erimozcan/CentrifugeFirmware/repo/esc_firmware/src/sensorless_observer.h

#ifndef SENSORLESS_OBSERVER_H
#define SENSORLESS_OBSERVER_H

#include <Arduino.h>

struct SensorlessObserverConfig {
  float polePairs;
  float phaseResistanceOhm;
  float phaseInductanceH;
  float kvRpmPerVolt;
  float pllKp;
  float pllKi;
  float minBemfVolts;
  float lockPhaseErrorRad;
  float lockRpmError;
  float lockDwellMs;
  float maxRpm;
  float latencySec;   // fixed frame-skew compensation applied as angle offset
                      // (= electricalOmega * latencySec; NEGATIVE retards). Bench-fitted
                      // 2026-07-17: the raw estimate LEADS the encoder reference frame by
                      // omega*240us (39deg@3800 / 44.8@4500 / 49.2@5000 RPM), so the
                      // production value is -240e-6 -- verified to null the bias to ~1 deg.
};

class SensorlessObserver {
 public:
  void begin(const SensorlessObserverConfig &cfg);
  void reset();   // zero all state WITHOUT claiming lock (resetFromElectrical latches
                  // locked=true for the handoff seed -- wrong for a fresh shadow start)
  void resetFromEncoder(float mechanicalAngleRad, float mechanicalRpm);
  void resetFromElectrical(float electricalAngleRad, float mechanicalRpm);
  void update(float ia, float ib, float ic,
              float uq, float ud, float voltageAngleElectrical,
              float encoderElectricalAngle, float encoderMechanicalRpm,
              float dt);

  float angleElectrical() const { return electricalAngle_; }
  float rpmMechanical() const { return mechanicalRpm_; }
  bool locked() const { return locked_; }
  float phaseErrorToEncoder() const { return phaseErrorToEncoder_; }
  float bemfVolts() const { return bemfVolts_; }

 private:
  static float wrapPi(float angle);
  static float normalizeAngle(float angle);

  SensorlessObserverConfig cfg_{};
  bool configured_ = false;
  bool locked_ = false;
  float electricalAngle_ = 0.0f;
  float electricalOmega_ = 0.0f;
  float mechanicalRpm_ = 0.0f;
  float lastIalpha_ = 0.0f;
  float lastIbeta_ = 0.0f;
  float lockMs_ = 0.0f;
  float phaseErrorToEncoder_ = 0.0f;
  float bemfVolts_ = 0.0f;
};

#endif
