erimozcan/CentrifugeFirmware/(commit log)

2026-07-12 Remove inherited dead code; stop tracking build artifacts
    - Delete the abandoned ODrive safety-kernel tree (src/, gen1_safety_kernel.ino)
    and its Due/ODrive-era docs (repo/PINOUT.md, repo/WIRING.md)
    - Delete the legacy Python CLI (repo/python/), superseded by the web operator UI
    - Delete the stale duplicate repo/firmware/src/main/main.ino
    - Untrack repo/firmware/.pio build artifacts (already gitignored)
    - Ignore local AI-assistant/analysis artifacts (.claude/, CLAUDE.md, graphify-out/)
    The 5th/ directory (abandoned STM32 MCSDK project, never tracked) was
    deleted from disk as well.
2026-07-12 Add the final device code: firmware, ESC firmware, operator UI, voice lines
    The complete software for the shipped centrifuge:
    - repo/firmware/: master-controller firmware for the Arduino Nano ESP32
    (state machine, safety interlocks, door/lock/fan/LED/audio drivers, ESC
    bridge, WiFi console server). Production env is nano_esp32; the bench
    diagnostic envs are kept and documented as service tools, and the Due
    product envs are removed (the Due was the prototype board).
    - repo/esc_firmware/: spindle ESC firmware (B-G431B-ESC1 + SimpleFOC).
    - repo/ui/: browser operator console (Web Serial over USB), including the
    self-contained single-file centrifuge-usb.html.
    - CentrifugeVoiceLines/: s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
2026-07-14 Raise RPM cap to 7000 (24 V bus validated); add live run-phase timers to UI
    - MAX_RPM_BAREBONES 4000 -> 7000 after the move to the 24 V bus and bench
    validation of the high-speed regime; docs updated accordingly
    - UI (both variants): raise speed input/clamp/bar full-scale to 7000
    - UI: live countdowns for ramp-up (LIFT/SEAT/MAIN), spin hold, and stopping,
    anchored on polled state transitions using the profile doRun() sent;
    shows elapsed time instead if the page loads mid-run
    - Regenerate embedded data/index.html.gz for the device-served WiFi console
2026-07-14 Add spindle service mode and high-speed controls
2026-07-14 Raise ESC current limits to 5A
2026-07-14 Fix ESC calibration safety gates
    [command_interface.cpp, main.cpp, test_esc_calibration_static.py]
2026-07-17 Harden high-speed sensorless mode and switch tube indexing to the ESC
    ESC (b_g431_esc1):
    - Supply-aware SPIN ceiling: min(10000, KV*(VBUS/2 - margin)) -- ~5720 RPM on
    12 V, full 10k only with -D SUPPLY_VOLTAGE=24.0f on the real 24 V bus.
    - Observer shadow validation now feeds the ACTUAL FOC voltages (motor.voltage
    q/d), not a hypothetical open-loop schedule.
    - Commanded ramp-down from sensorless speed hands back to encoder FOC at the
    crossover instead of riding the observer down into a cosmetic fault.
    - CAL: align waits CAL_LOCK_RELEASE_MS for the master to retract the gantry
    lock; encoder-still check handles TIM4 counter wrap.
    - New HOME verb captures the detent reference; INDEX tar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
2026-07-17 Never claim observer lock at standstill
    startCalibration() seeded the observer with resetFromElectrical(), which
    latches locked=true (the handoff seed) -- so ST telemetry showed obs_lock=1
    while the rotor sat still during CAL. Found during the powered-off dry test
    of the freshly flashed ESC. Add SensorlessObserver::reset() (zero state, no
    lock claim), use it at CAL start and on every disarm so no stale lock can
    survive into the next arm.
    Verified on hardware over the ST-LINK VCP: obs_lock=0 during CAL on both the
    default and _hs builds; full dry-test suite passes (verbs, profiles, HOME,
    watchdog, no-bus arm refusals, CAL lock-release dwell + graceful timeout).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
    [main.cpp, sensorless_observer.cpp, sensorless_observer.h, test_high_speed_supply_and_safety_static.py]
2026-07-17 Bench-harden indexing, calibration, and observer from powered testing
    First powered bring-up of the new ESC (daughterboard VCP, 12 V bench).
    Every change here is bench-driven:
    - INDEX reworked from an angle servo to a settled velocity crawl: a position
    loop closed through the assembly's stiction limit-cycles (observed: hunting,
    transient-crossing false arrivals). The crawl approaches fast, creeps near
    the target, cuts drive a stop-lead early, verifies a SETTLED arrival (dwell
    above the encoder's velocity-quantization noise floor), and takes bounded
    bidirectional correction passes with a pulsed stiction kick. Final bench
    result: 19/19, landings -5.0/+3.7/-0.4/-0.3/-0.3 deg, exact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
    [config.h, main.cpp, sensorless_observer.cpp, sensorless_observer.h, test_esc_calibration_static.py, test_esc_native_indexing_static.py, test_high_speed_supply_and_safety_static.py]
2026-07-17 High-speed regime: supervised encoder FOC full-range; handoff experimental
    Second powered bench session (new ESC, encoder remounted, bucketless rotor,
    12 V). Iterated the high-speed regime to a validated shipping architecture:
    - Observer frame-skew compensation SIGN was backwards and belongs ONLY in the
    supervision comparison: raw estimate LEADS the encoder frame by omega*240us
    (advance doubled the bias: 76/88/99 deg measured; retard nulls to ~1 deg),
    and compensating the PLL's own angle biased the sensorless drive frame
    (~45 deg torque-angle lag, 9 A). Compensation now applies only to
    phaseErrorToEncoder. Shadow lock validated on hardware: phase err within
    ~4 deg from 3800 to 5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
2026-07-17 Index crawl: sustain breakaway under bucket load
    Loaded regression (buckets reinstalled) exposed the last indexing gap: at the
    15 RPM creep the velocity-P term commands only ~2.4 A against the assembly's
    ~4.5 A stiction, so after every kick pulse the move re-stalled -- visible as
    back-and-forth jiggle at the bench, landings -13/-36 deg with retries
    exhausted. Creep raised to ~27 RPM (P-term ~4.2 A sustains motion once
    moving), kick pulse 40 -> 70 ms, retries 6 -> 8.
    Loaded results: indexing 19/19 (landings -0.4/-3.6/+2.9/-4.6/+5.0 deg,
    single-pass moves, bidirectional exact); full loaded regression on the
    default 4000-cap build: basic 13/13, CAL 6/6.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
    [main.cpp]
2026-07-17 Brisker door; INDEX re-send is a keep-alive, not a restart
    - Door drive raised per operator request: run duty 130 -> 160 (~63%), kick
    duty 100 -> 125. DOOR_SPEED verb still overrides live.
    - ESC: a re-sent INDEX for the same tube while the move/hold is live now
    acks and continues instead of restarting the crawl. The master re-sends
    INDEX every 250 ms until arrival (dropped-line robustness), and each
    restart raced the 200 ms settle dwell so arrival could never latch --
    found in the first full Nano end-to-end (post-R23/R24): standalone
    ROTATE limped through in 18.8 s, the post-run RUN_INDEX timed out and
    latched FAULT_ROTATE_TIMEOUT.
    - End-to-end otherwise proved the stack: Nano<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
2026-07-22 Fix missing home capture on the INDEX path; retune for low-friction gantry
    The rebuilt gantry (much less static friction) exposed two problems:
    - REAL ROOT CAUSE of "indexing off" and "homing off": maintainHome() was only
    called on the legacy velocity-rotate branch -- the ROTATE_VIA_INDEX dispatch
    never captured the detent reference or synced HOME to the ESC, so HOMED
    stayed 0 and every tube target was measured from wherever the ESC happened
    to power on. Pre-rebuild that was coincidentally near a detent. Fixed +
    regression test; verified on hardware (HOMED=1, ESC acks HOME).
    - Low-friction retune (staged; ESC flash pending ST-LINK): CRAWL velocity
    P 1.5 -> 0.5 (stiction-sized ga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
    [audio_controller.cpp, audio_controller.h, config.h, main.cpp, state_machine.cpp, test_esc_native_indexing_static.py]
2026-07-22 Smooth the index crawl: softer gains, gentler speeds, 2 A torque ceiling
    Landings were in tolerance but the move still jiggled on the low-friction
    gantry. Per operator request, power the motor less and soften everything:
    CRAWL velocity P 0.5 -> 0.3 (P x velocity quantization at creep dithers the
    torque), cruise 40 -> 30 RPM (smaller FAST->SLOW braking step), stall kicks
    rarer (200 -> 400 ms window) and softer (40 -> 30 ms pulse), and a dedicated
    2 A current ceiling for index moves (vs the global 5 A) so no correction can
    jerk the gantry -- restored with the spin profile on disarm.
    [main.cpp, test_esc_native_indexing_static.py]
2026-07-28 Door motor on the 24 V bus: PWM duty scaling instead of a 12 V buck
    The N20 door motor (BOM M2) is a 12 V-max part but the 24 V rework puts
    the DRV8871 VM straight on the 24 V rail (no enclosure room for the
    BOM's P2 buck). The 20 kHz slow-decay H-bridge PWM into the winding
    inductance is already a buck stage, so updateDoorMotor() now rescales
    every commanded duty (kick, run, UI DOOR_SPEED -- all calibrated on the
    12 V rail) by DOOR_MOTOR_RATED_V/DOOR_VM_VOLTAGE at the write. Average
    motor voltage is unchanged (255 commanded -> 127 applied); full VM can
    never reach the motor through the production path.
    The three bench tests that bypass this and kick at full VM
    (door_digi_test / door_test /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
    [config.h, door_digital_test.cpp, door_motor_test.cpp, door_move_test.cpp, hardware_guard.cpp]
2026-07-28 Enable the 24 V supply flag in the ESC high-speed env
    Flashed to the device 2026-07-28 as part of the 24 V single-bus
    migration (matching nano_esp32_hs on the master). The build must match
    the physical supply: do not spin on a 12 V bench supply with this
    configuration.
2026-07-28 UI: RCF units (r=52.5 mm); drop the high-speed toggle after 10k validation
    10,000 RPM on the 24 V bus was validated on the device 2026-07-28, so the
    opt-in "high-speed validation mode" checkbox + warning are gone -- the
    full range is simply the range. Operator speed is now RELATIVE
    CENTRIFUGAL FORCE (x g) at the 52.5 mm tube radius (RCF = 1.118e-5 x
    r[cm] x rpm^2); the machine protocol stays RPM underneath, with the raw
    RPM kept as the hero's secondary readout and in the debug telemetry.
    Max input is 5869 x g == the validated 10,000 RPM ceiling, DERIVED from
    MAX_RUN_RPM in code (floor keeps the converted rpm <= the firmware
    clamp). Deliberately NOT the requested 15,000 RPM equivalent (13,20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
2026-07-28 Raise the ceiling to 12000 RPM (8452 x g) -- the 24 V bus physical max
    After 10k validated on the device, open up the remaining supply headroom:
    KV*(VBUS/2 - margin) = 12320 ideal at 24 V, minus IR/load losses ~= 12k
    practical. MAX_SPIN_RPM_DESIGN and MAX_RPM_BAREBONES (hs) 10000 -> 12000;
    UI max 8452 x g (= 12k RPM at r 52.5 mm), still derived from MAX_RUN_RPM.
    MOTOR_VEL_LIMIT 200 -> 210 rev/s: it was exactly 12000 RPM and would have
    clipped the top-of-range velocity setpoint.
    Near the ceiling the measured speed falling short of the command is the
    bus limit, not a fault (documented in the source). 10k-12k needs the
    same incremental on-device validation as 7k-10k.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
    [config.h, main.cpp, test_high_speed_supply_and_safety_static.py, test_ui_high_speed.py]
2026-07-28 Raise the ESC spin current limit 5 -> 8 A (loaded-tube torque headroom)
    With tubes loaded, aero drag current-limited the spin at ~9.7k RPM
    (5.5k xg) with the phase current pegged at the 5 A clamp (bus draw read
    only ~2.5 A at 24 V -- same power, converter side). 8 A keeps 2.2x
    margin to the motor's 18 A / 200 W-for-30 s rating and 5x to the board's
    40 A peak (UM2516); expect ~6-7 A sustained at the loaded top, so watch
    motor temperature on long holds. The experimental (disabled) sensorless
    drive keeps its conservative 5 A trip. Requires PSU current limit >= 8 A.
2026-08-01 Lock at 95% throw; post-run bucket-tamp pass before the final lock
    The PQ12-R's position is linear in pulse width, so LOCKED becomes 1050 us
    (95% extend) -- the full throw over-drove the pin. The spun buckets are too
    light to fold back down, so after the post-spin index (door still closed)
    the gantry now visits the midpoint between each detent pair, where the
    bucket sits under the pin, and the lock presses to 75% (1250 us) to fold it
    flat, then retracts and moves on; after all four, the normal re-index,
    lock, and door-open run unchanged. New states RUN_TAMP_MOVE/RUN_TAMP_PRESS
    (19/20) keep the lock policy "released" through the pass so the rpm safety
    net and the lock audio cues behave; the p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
2026-08-01 Replace the bucket-tamp pass with a 50% sweeper knockdown turn
    Bench result: per-bucket 75% presses mostly worked, but a reworked lock tip
    with a sweeper extrusion does it better in one motion -- held at 50% extend
    it knocks each bucket flat as the gantry turns past it. After the post-spin
    index (door still closed) the lock now extends halfway, the gantry does one
    slow full revolution (30 RPM, crawl profile), then the normal re-index +
    lock + door-open follow. The turn's progress is measured on the ESC's
    cumulative rev= telemetry -- circular angle can't express "one full turn"
    (start == end) -- and stops 4% short so the re-index approaches the detent
    forward. States 19/20 become RUN_SWEEP_EX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
    [config.h, context.h, hardware_guard.cpp, hardware_guard.h, main.cpp, motor_interface.cpp, motor_interface.h, state_machine.cpp]
2026-08-01 Make the full-range _hs builds the default flash targets
    A plain `pio run -t upload` flashed the validation-era capped defaults
    (nano_esp32 = 4000 RPM master clamp; b_g431_esc1 = 12 V supply caps), which
    bit on 2026-08-01: a 4000 x g run silently clamped to 4000 RPM. The device
    has run the _hs configuration since the 24 V migration + 10k validation, so
    default_envs now points there in both projects and the env comments say
    which build the machine actually runs.
    Claude-Session: https://claude.ai/code/session_019sSbEiR3DxpyRa72cPWxa7
2026-08-03 Slew-limit the INDEX approach launch (bucket-slosh jerk guard)
    The index crawl stepped its velocity setpoint 0 -> FAST (~30 RPM) in one
    loop; through the boosted crawl PID that launch was hard enough to slosh
    loaded buckets on every from-rest move (initial index, tube rotate, the
    post-run and post-sweep re-indexes). Approach speed-ups now slew at
    INDEX_ACCEL_RADPS2 (1 rev/s^2 -> FAST in ~0.5 s). Slow-downs and the stop
    cut stay immediate so the landing recipe is untouched, and the stiction
    kick keeps its full step -- a ramped kick cannot break a stall.
    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
    [main.cpp]
2026-08-03 UI: default run ramp 10 s -> 120 s (max 120 -> 600)
    Gentler default spin-up/down for loaded buckets; the field ceiling moves up
    so 120 s is a starting point, not the limit.
    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
2026-08-03 Raise door drive ~15%: kick 150 -> 170, run duty 192 -> 220
    Second door-power bump (first was 2026-07-21). Duty 255 is the N20's full
    12 V rating on the VM-rescaled 24 V bus, so ~15% headroom remains.
    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
2026-08-03 UI: cap operator RCF at 6000 x g for now
    The hardware ceiling stays 12000 RPM (~8452 x g); the console just won't
    ask for more than 6000 (~10.1k RPM) until higher-g runs are wanted. The
    static test now checks the cap stays under the RPM ceiling instead of
    requiring MAX_RCF to derive from it.
    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
    [test_ui_high_speed.py]
2026-08-04 Lock crush guard: never extend the full throw off-detent
    Field failure: after a sweep the lock engaged at a HALF-detent and crushed
    a tube. Likely chain: a lock-actuator stall (50% sweeper knocks, or the
    restored full engage throw) drooped the shared 5 V rail -- the documented
    brownout-reboot risk -- so the Nano rebooted mid-cycle, blind-extended the
    lock at boot wherever the gantry sat (a bucket), and re-captured HOME
    there, shifting every detent by half a slot for good measure. Three
    independent guards, each sufficient to stop the crush:
    - Boot RETRACTED; the lock engages only once ESC telemetry verifies a
    learned detent under the pin (manual bench LOCK still bypasses -- a rig
    with no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
    [config.h, context.h, hardware_guard.cpp, main.cpp, motor_interface.cpp, motor_interface.h, state_machine.cpp, test_lock_crush_guard_static.py]
2026-08-04 Give the lock dwells the actuator's REAL stroke time
    The PQ12-63's full 20 mm stroke takes ~1.6-2 s (15 mm/s max, ~17% slower
    on the shared 5 V rail), but the release/engage dwells were 800 ms -- the
    spin started with the pin only ~60% retracted, and the door opened before
    it fully seated. Release/engage 800 -> 2500 ms, sweep half-stroke extend
    800 -> 1500 ms, ESC pre-calibration release 1500 -> 2500 ms. The lock is
    open-loop (the -R has no position output), so dwell time is the only
    guarantee it completed its travel.
    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
2026-08-04 UI: make the post-run finishing tail (bucket sweep) unmistakable
    The quiet ~15 s between spin-down and door-open read as a hang. The whole
    tail (settle, re-index, bucket sweep, final lock) now gets its own hero
    scene -- blinking run pill, caption "Finishing run · sweeping buckets
    down" -- and the sweep states read FINISHING · SWEEP on the chips. Also
    un-groups RUN_INDEX (18) from the door-open ROTATE states: it is part of
    the door-closed run tail and was showing the "Door open" scene.
    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
2026-08-04 Add an Opentrons OT-2 client, control protocol, and debug console
    The Nano's USB goes into the OT-2's Raspberry Pi and protocols drive the
    centrifuge over the existing sequence-numbered line protocol -- no firmware
    change. Opentrons has no third-party module SDK for the OT-2, so external
    hardware is always "your own code in the protocol"; this is that code.
    - opentrons/centrifuge.py: synchronous client. Finds the port by VERSION
    handshake (never the robot's own motion controller), matches replies by
    sequence number through the ESC telemetry the device interleaves, and
    aborts any wait the moment a fault latches.
    - opentrons/centrifuge_control.py: single-file protocol for the app. Runti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
2026-08-04 Fix runs faulting after the sweep: keep our detent grid slaved to the ESC's
    Root cause of the DETENT_MISMATCH that ended every run: the ESC's home
    reference defaults to raw encoder ZERO and is only set by the HOME verb,
    while the master homed exactly once at boot and never revisited it. Reflash
    or reboot the ESC after the master has homed -- which is precisely what
    flashing Nano-then-ESC on 2026-08-04 did -- and the two ends silently
    disagree: INDEX 0 drives to encoder zero, which is not a detent, so the new
    crush guard correctly refused to lock and latched a fault. The guard was
    right; the reference handling was wrong.
    maintainHome() now reconciles every tick instead of running once:
    - ESC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
    [centrifuge.py, centrifuge_control.py, config.h, context.h, motor_interface.cpp, motor_interface.h, protocol.cpp, state_machine.cpp]
2026-08-04 Client: assert DTR, or the Nano's USB CDC discards every reply
    First bench test of the OT-2 client found it could not talk to the board at
    all. The client deasserted DTR/RTS before opening, reasoning that a USB-CDC
    open can reset an ESP32 -- but the Nano ESP32 is NATIVE USB CDC and the S3
    gates its transmit on the host's DTR line state. With DTR low the board
    accepts commands and silently drops the replies, which the client reports
    as "no centrifuge firmware on this port". Verified against the hardware:
    default line states answer VERSION immediately.
    Confirmed working end to end afterwards: auto-detection, VERSION handshake,
    STATUS parsing, and the new DETENT_OK / DETENT_D10 diagnostics.
    C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
    [centrifuge.py, centrifuge_control.py, test_opentrons_client_static.py]
2026-08-05 Sweep hold 50% -> 40%; fix the first index overshooting the tube
    Lock: LOCK_PULSE_SWEEP_US 1500 -> 1600. Travel is linear in pulse width
    (extend % = (2000 - pulse) / 10), so the sweeper now reaches 40% instead of
    50% -- it was pressing too far into the buckets. Comments that hard-coded
    "50%" now just say "the sweep hold" so the number lives in one place.
    Indexing: only the FIRST index after power-up misbehaved -- it lunged past
    the tube, reversed, then crept forward -- while 2->3, 3->4 and the rest
    crept in cleanly. That is exactly the one index that runs a FOC alignment,
    and two bugs stacked on it:
    - initFOC() physically swings the shaft ("motor twitches once"), and
    encoder.getAngle() r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
    [config.h, context.h, hardware_guard.cpp, main.cpp, motor_interface.cpp, motor_interface.h, state_machine.cpp, test_first_index_align_static.py]
2026-08-05 Lock travel: LOCK_PCT verb, UI slider, sweep hold to 30%
    Every sweep-depth change (50 -> 40 -> 30 so far) cost a full reflash, so
    make it a live control instead:
    - LOCK_PCT <0-100> drives the pin to an explicit travel. Same stopped-only
    gate as LOCK/UNLOCK, the rpm net still retracts it if the rotor turns,
    and a run or rotate clears the override like any other manual one.
    - STATUS reports LOCKPCT (the travel actually being driven), so the UI and
    the Python client can read it back.
    - Both consoles get a Lock travel slider in the debug drawer: label follows
    the drag, the command goes on release so a drag cannot flood the link,
    and STATUS syncs the knob unless the user is holding it.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
2026-08-05 Finalize the run cycle: bucket-sweep hold at 40%, OT-2 parity
    40% is the bench-tuned knockdown depth (50% reached too far, 30% too
    shallow), so LOCK_PULSE_SWEEP_US settles at 1600 and the UI slider defaults
    there. The live LOCK_PCT control and its slider stay -- they are how the
    number was found and how it gets re-tuned.
    The finalized post-run tail, for the record: settle -> index to a detent ->
    part-extend the lock to 40% -> one slow knockdown revolution -> re-index ->
    full lock -> open the door. Every step is guarded: the lock only extends
    onto a verified detent, and the sweeper retracts if the rotor ever exceeds
    SWEEP_ABORT_RPM.
    Brings the Opentrons side to parity, since it is next to b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
